Raffoo26/heat-sink-design/cad/cpu_source.stl

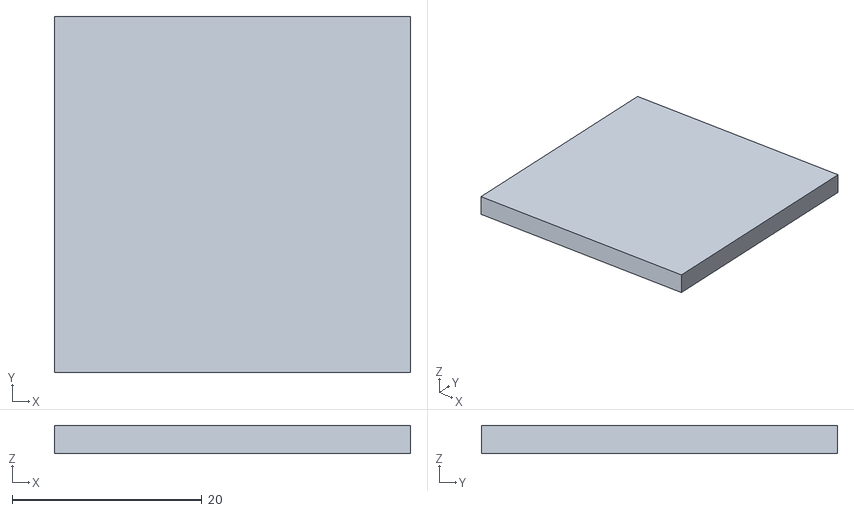
[picture p6: CAD file, 2026-11-11]
cad/cpu_source.stl
37.5 x 37.5 x 3.00
