Raffoo26/heat-sink-design/cad/led_natural_heatsink.stl

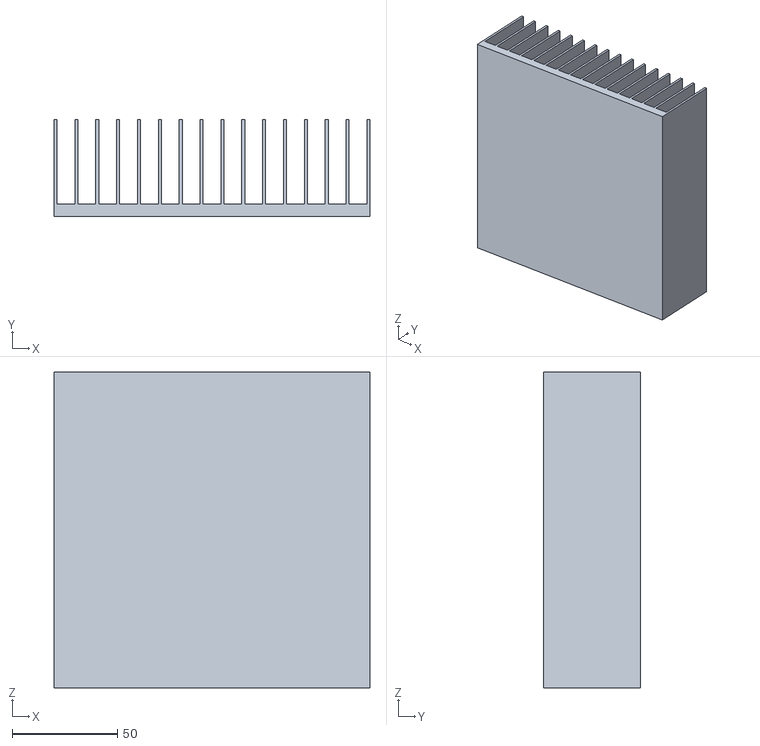
[picture p7: CAD file, 2026-11-11]
cad/led_natural_heatsink.stl
150.0 x 46.0 x 150.0
