Raffoo26/heat-sink-design/cad/cpu_fan_heatsink.stl

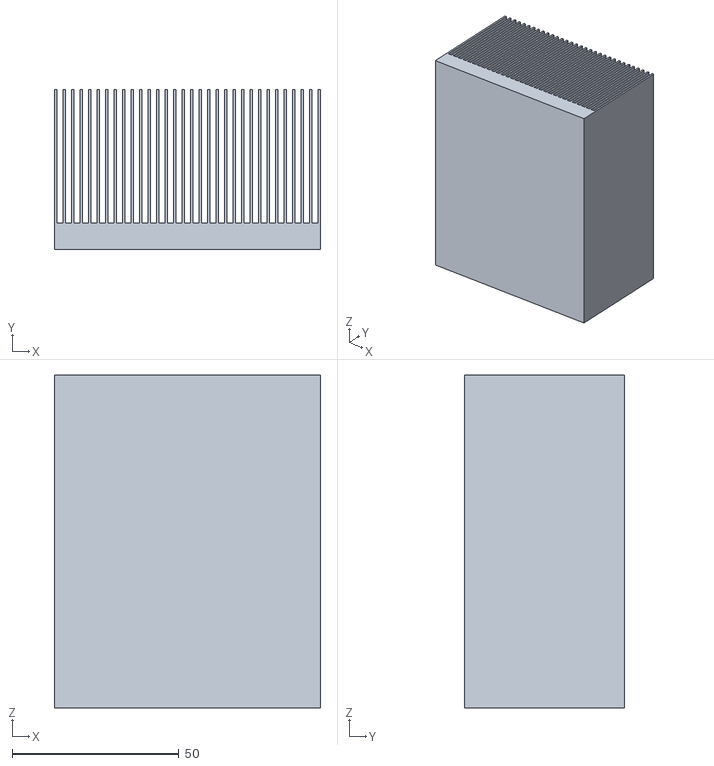
[picture p8: CAD file, 2026-11-11]
cad/cpu_fan_heatsink.stl
80.0 x 48.0 x 100.0
