Raffoo26/heat-sink-design/cad/led_source.stl

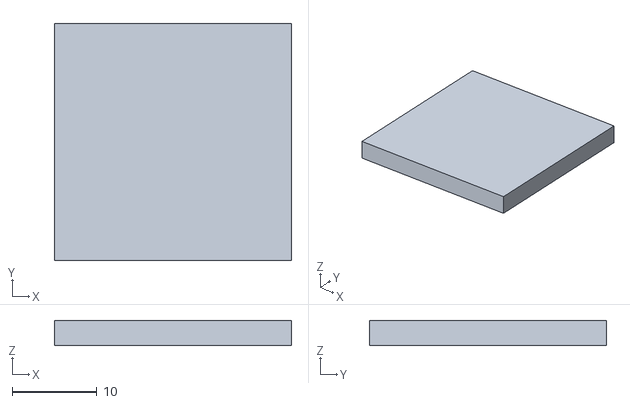
[picture p9: CAD file, 2026-11-11]
cad/led_source.stl
28.0 x 28.0 x 3.00
